vostsoldier/Yau-Flight-Computer/June 12th/image.png

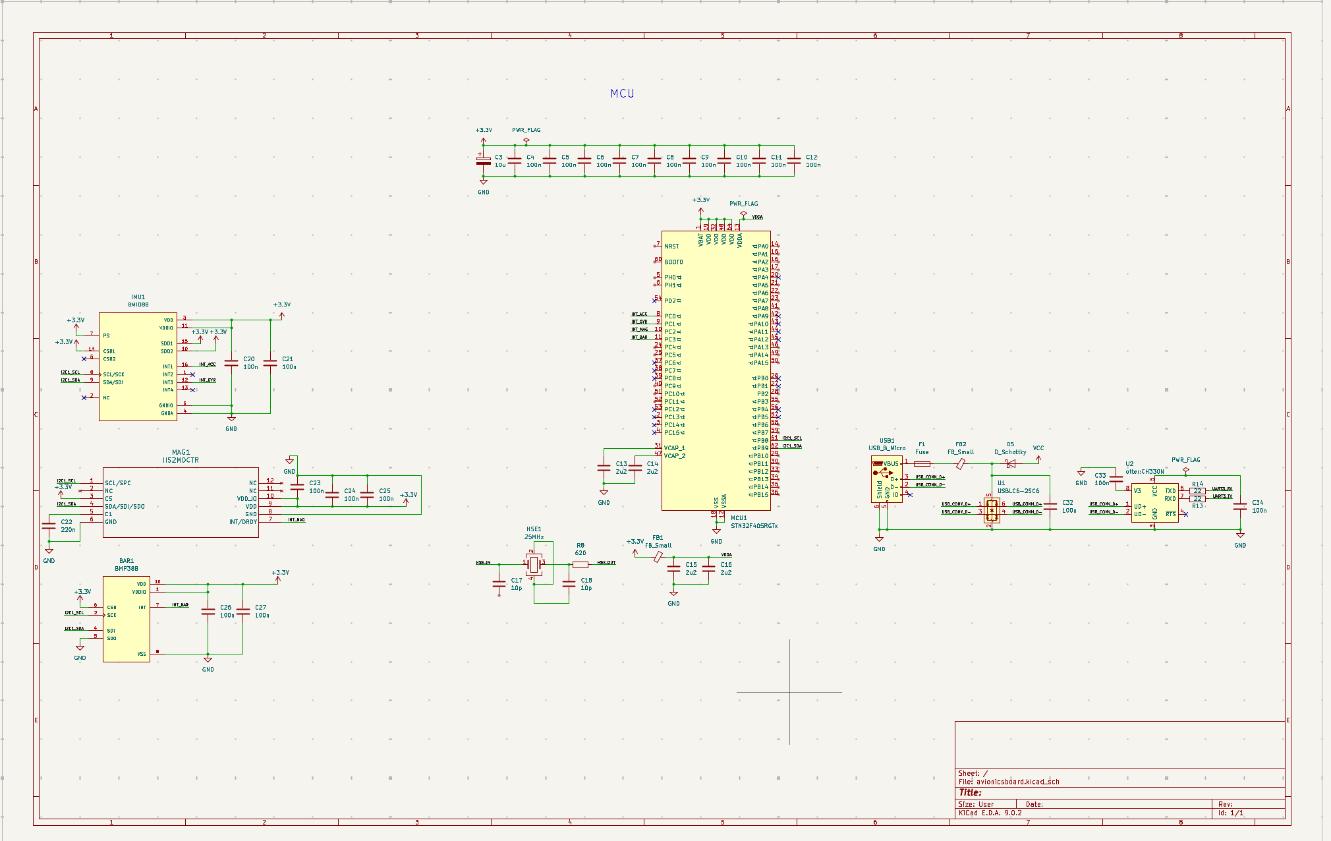
June 12th/image.png
