vostsoldier/Yau-Flight-Computer/June 13th/image.png

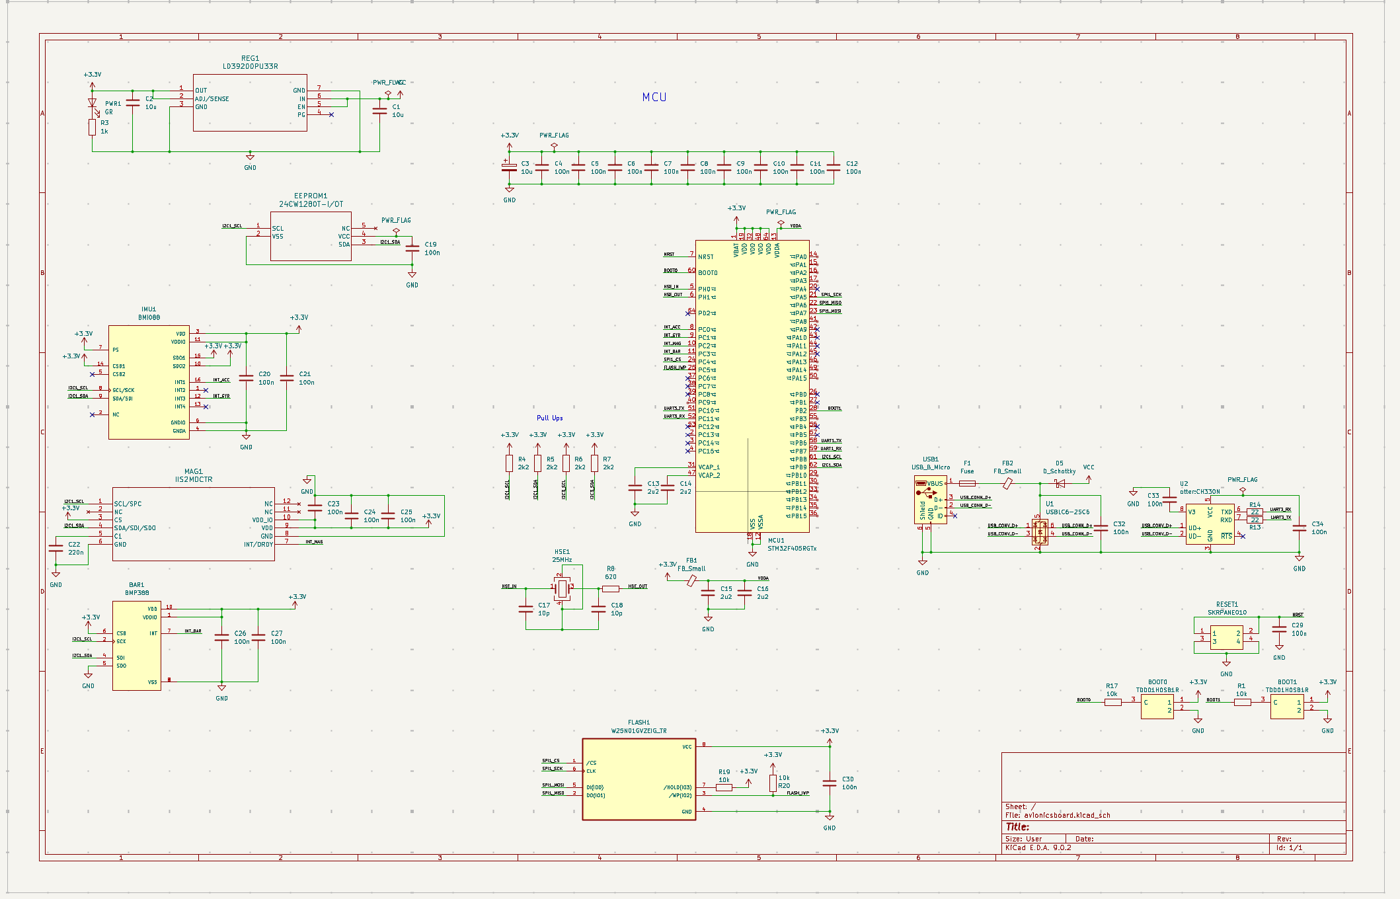
June 13th/image.png
