vostsoldier/Yau-Flight-Computer/June 14th/image1.png

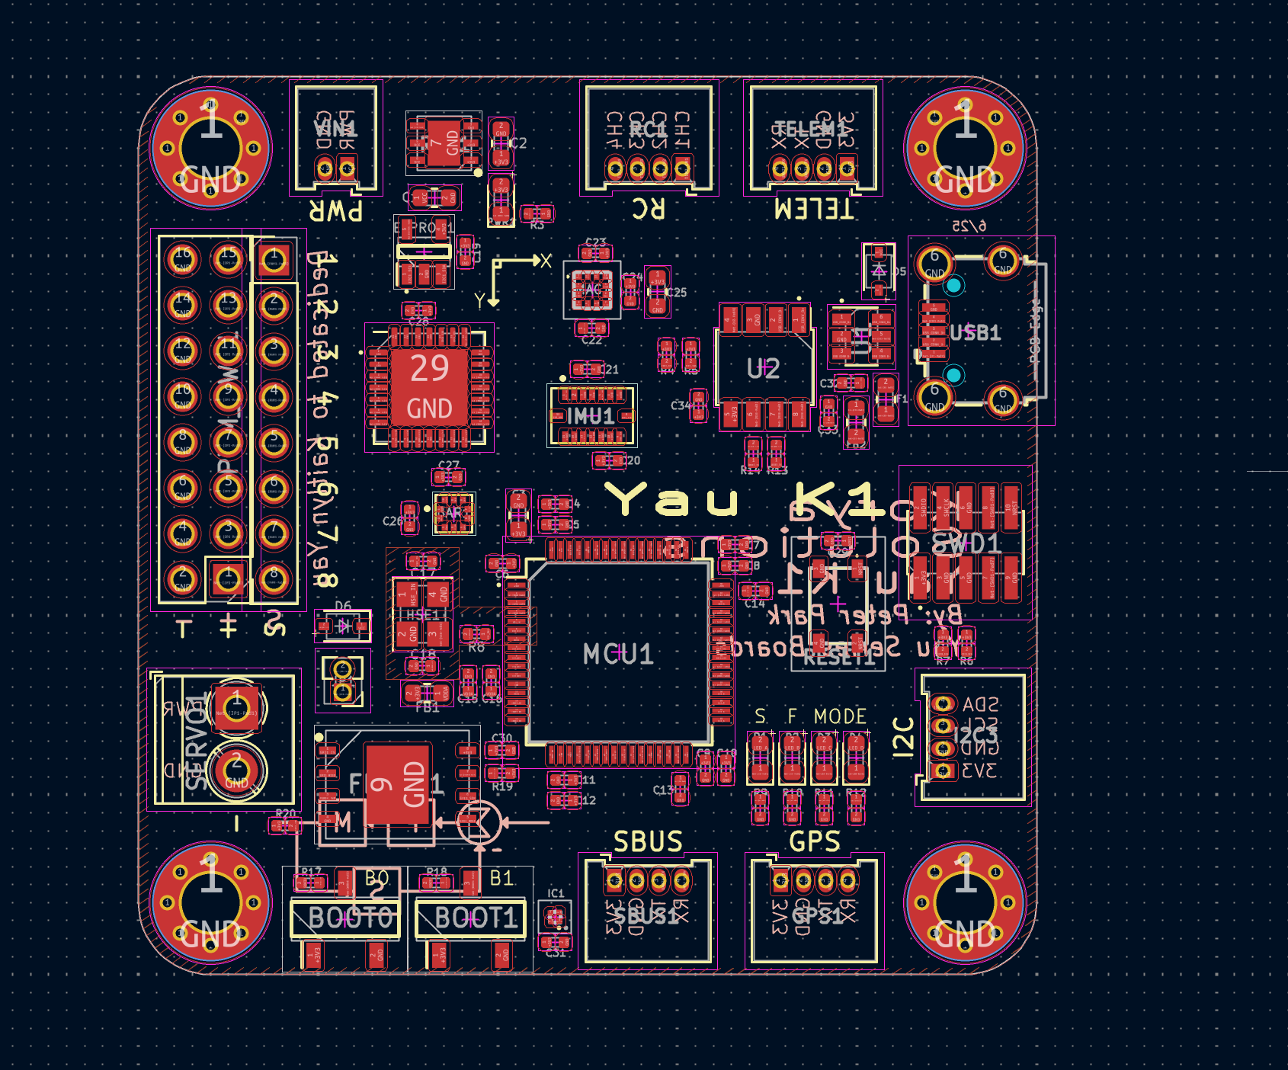
June 14th/image1.png
