vostsoldier/Yau-Flight-Computer/June 14th/image.png

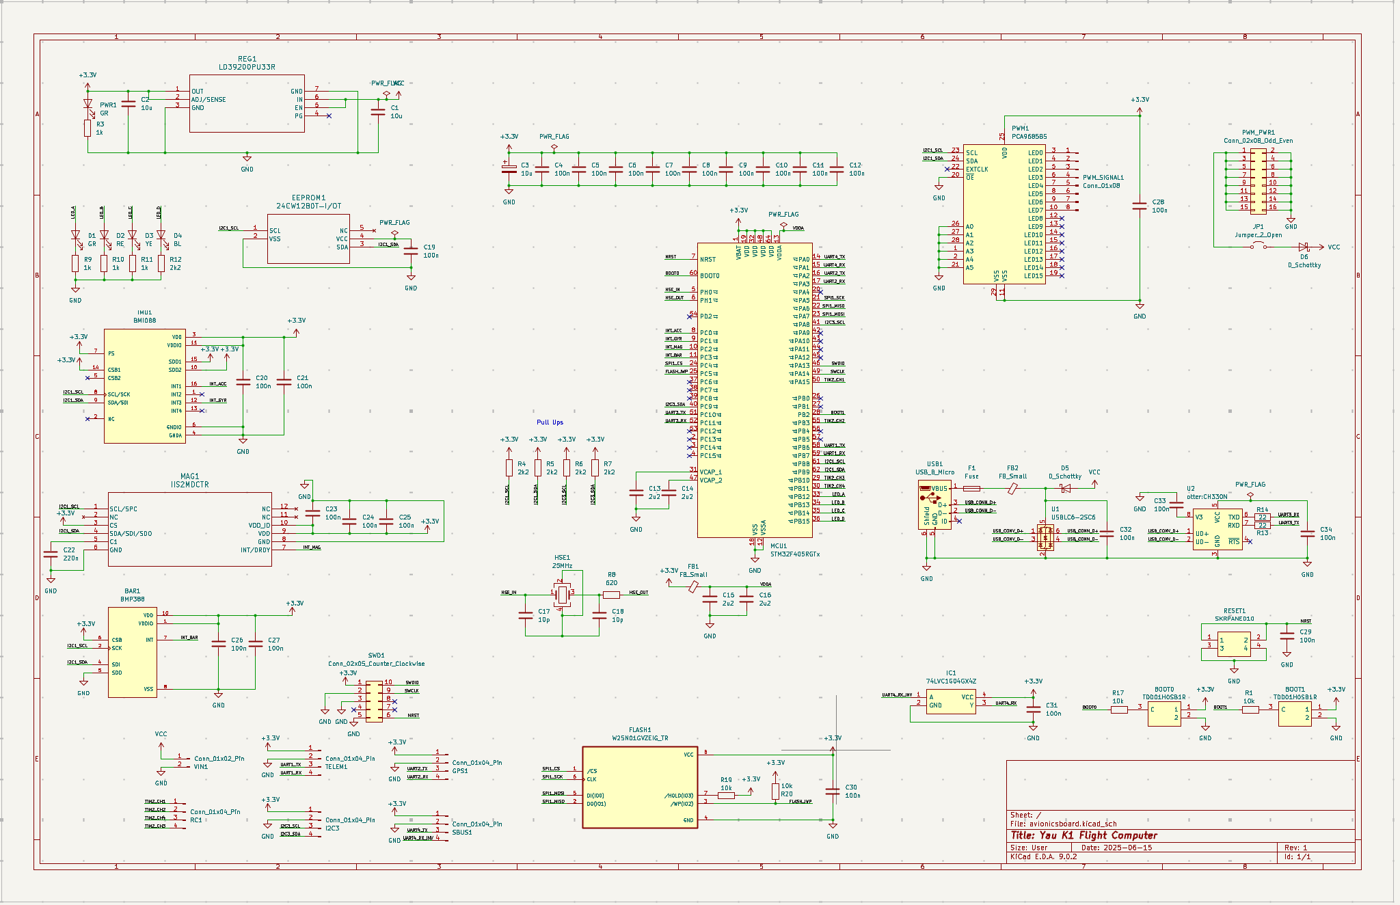
June 14th/image.png
