vostsoldier/Yau-Flight-Computer/June 15th/image.png

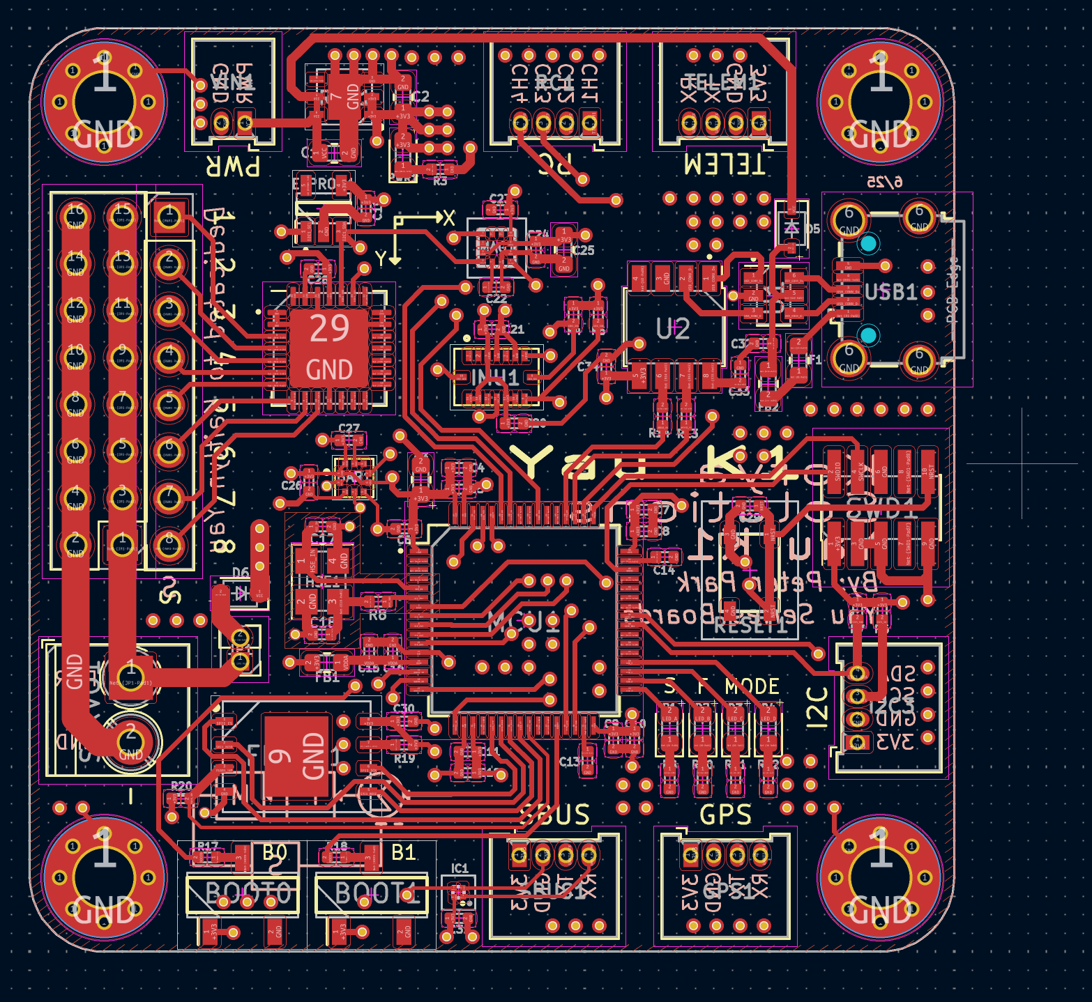
June 15th/image.png
