vostsoldier/Yau-Flight-Computer/June 16th/image1.png

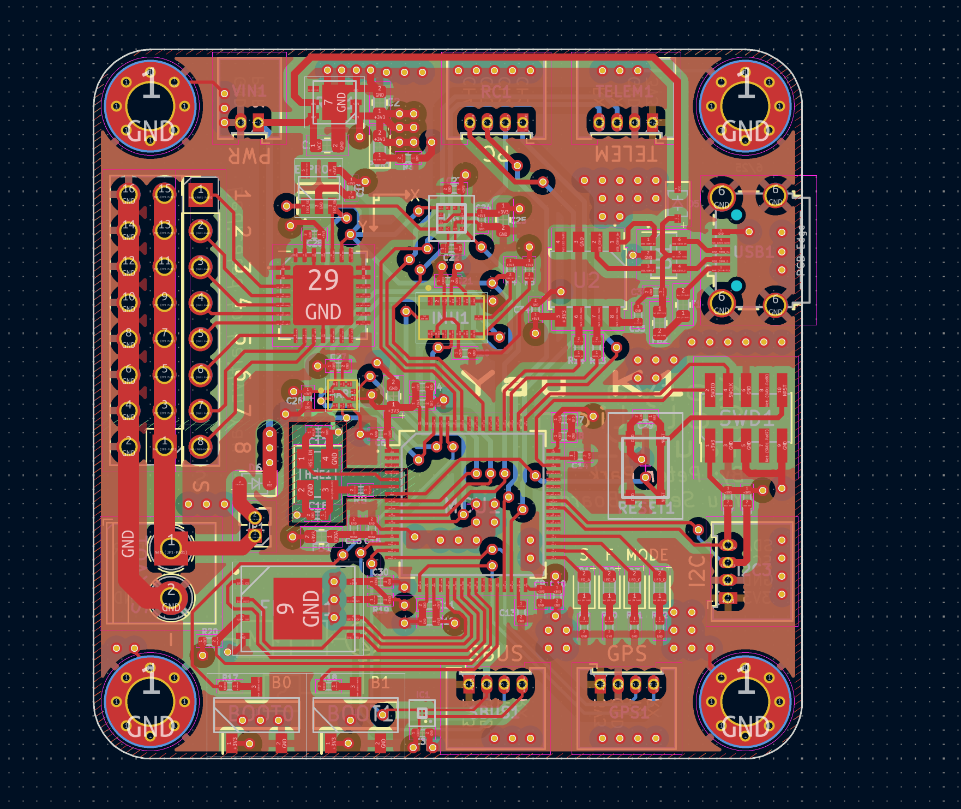
June 16th/image1.png
