vostsoldier/Yau-Flight-Computer/June 16th/image.png

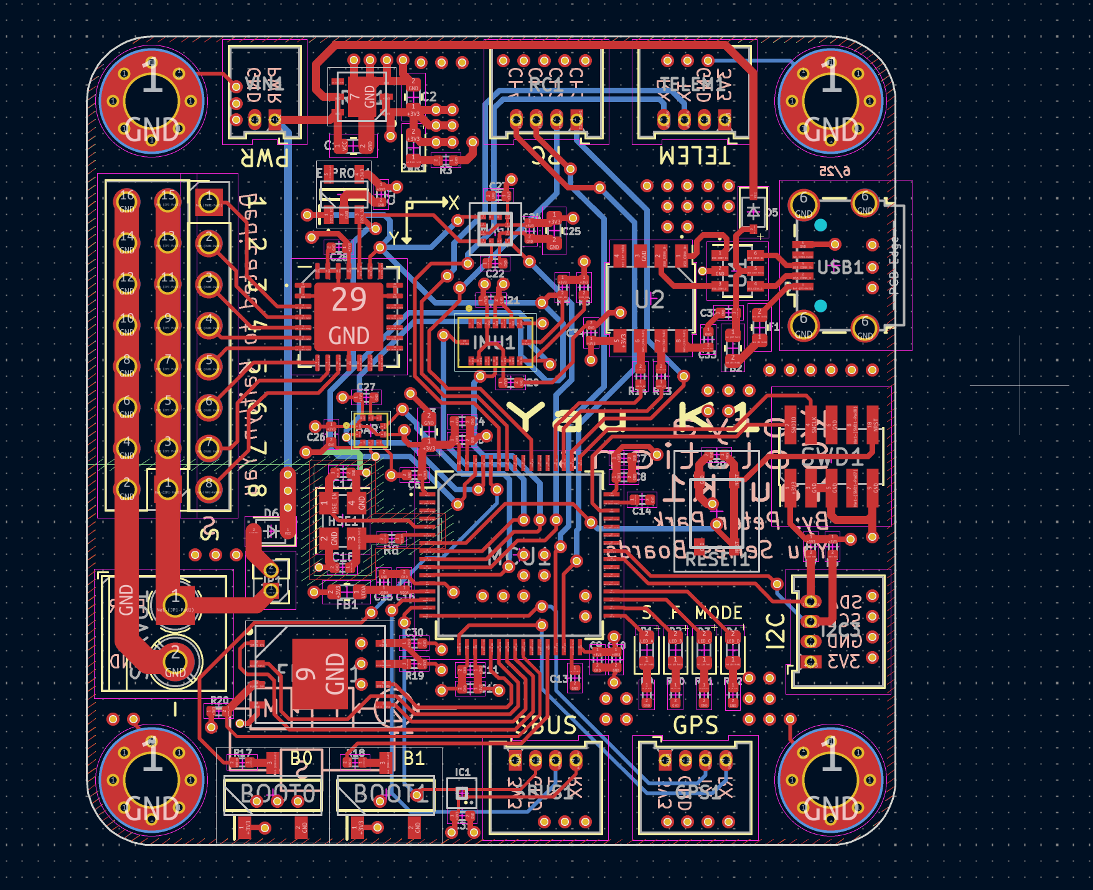
June 16th/image.png
