vostsoldier/Yau-Flight-Computer/Hardware/Onboard Computer/Yau Flight Computer.kicad_pcb

## KiCad design Hardware/Onboard Computer/Yau Flight Computer.kicad_pcb (2025-06-16)

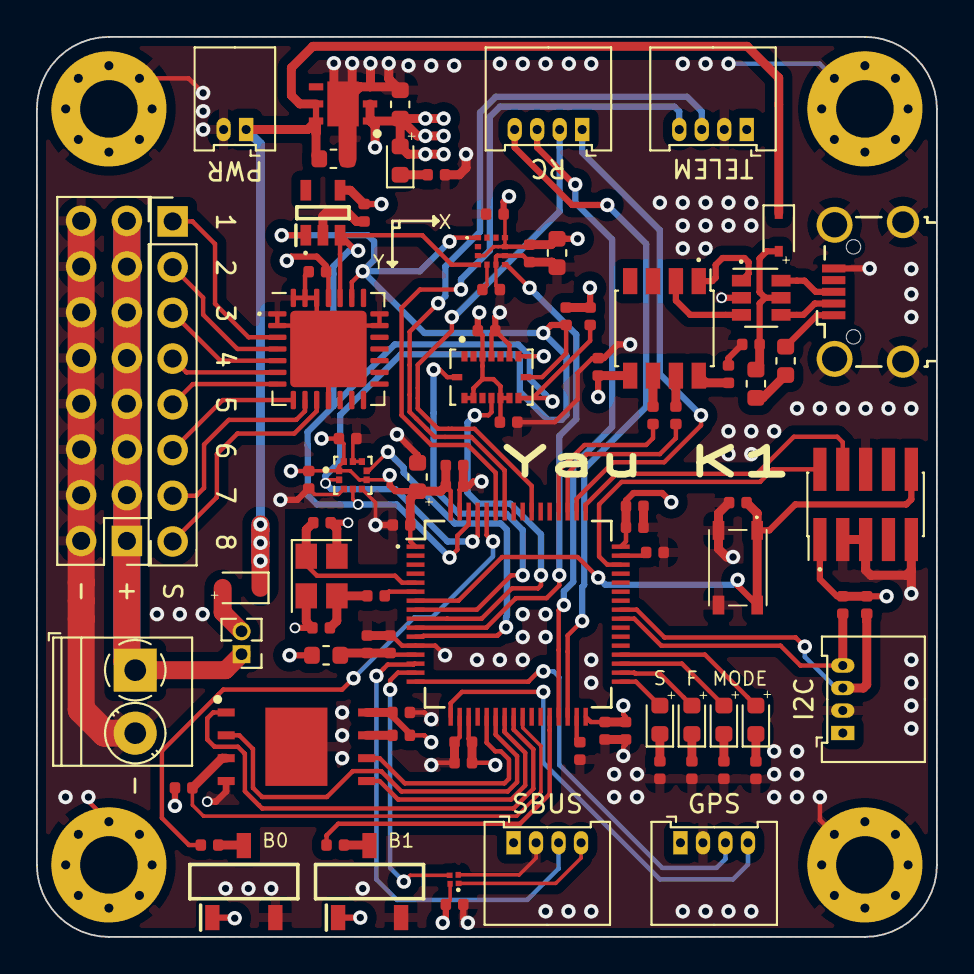
[picture p8: board Yau Flight Computer.kicad_pcb from above]

Board: 4 copper layers, 50.0 x 50.0 mm, 6 parts (0 on the bottom side), 2 nets.

Parts:
GPS: Conn_01x04; Molex_PicoBlade_53048-0810_1x04_P1.25mm_Horizontal
I2C: Conn_01x04; Molex_PicoBlade_53048-0810_1x04_P1.25mm_Horizontal
PWR: Conn_01x02; Molex_PicoBlade_53048-0410_1x02_P1.25mm_Horizontal
SBUS: Conn_01x04; Molex_PicoBlade_53048-0810_1x04_P1.25mm_Horizontal
SWD: Conn_02x05_Counter_Clockwise; PinHeader_2x05_P1.27mm_Vertical_SMD
TELEM: Conn_01x04; Molex_PicoBlade_53048-0810_1x04_P1.25mm_Horizontal

Connections:
+3V3: GPS.1, I2C.1, SBUS.1, SWD.1, TELEM.1
GND: GPS.2, I2C.2, PWR.2, SBUS.2, SWD.3, SWD.5, SWD.6, SWD.9, TELEM.2
